danielsaul/emg-sensor-scenario/Images/Subsystem.png

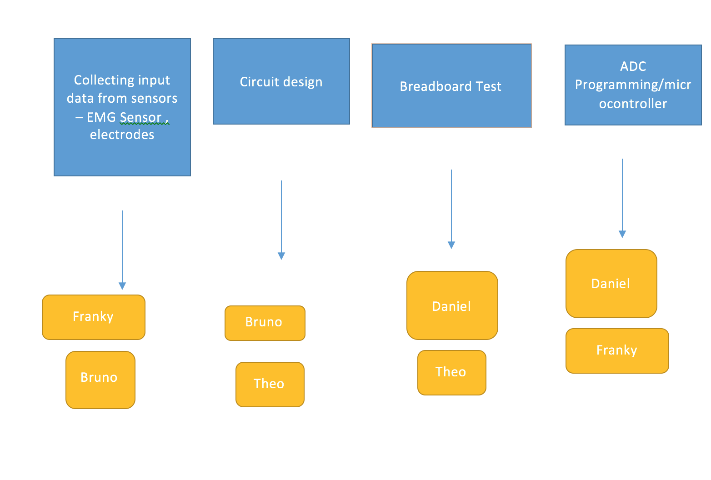
Images/Subsystem.png
