danielsaul/emg-sensor-scenario/Images/system multisim final with values.png

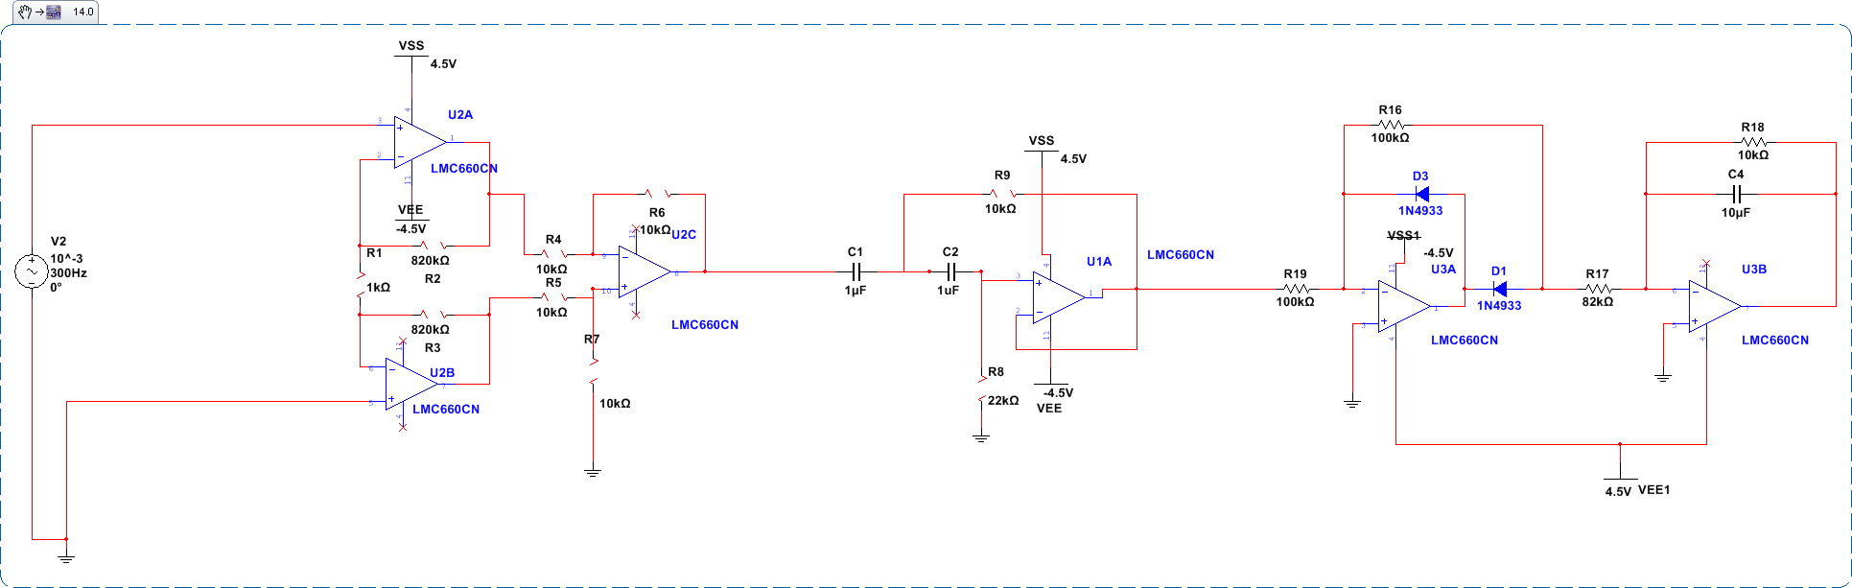
Images/system multisim final with values.png
