danielsaul/emg-sensor-scenario/Images/system-multisim-final-with-values.jpg

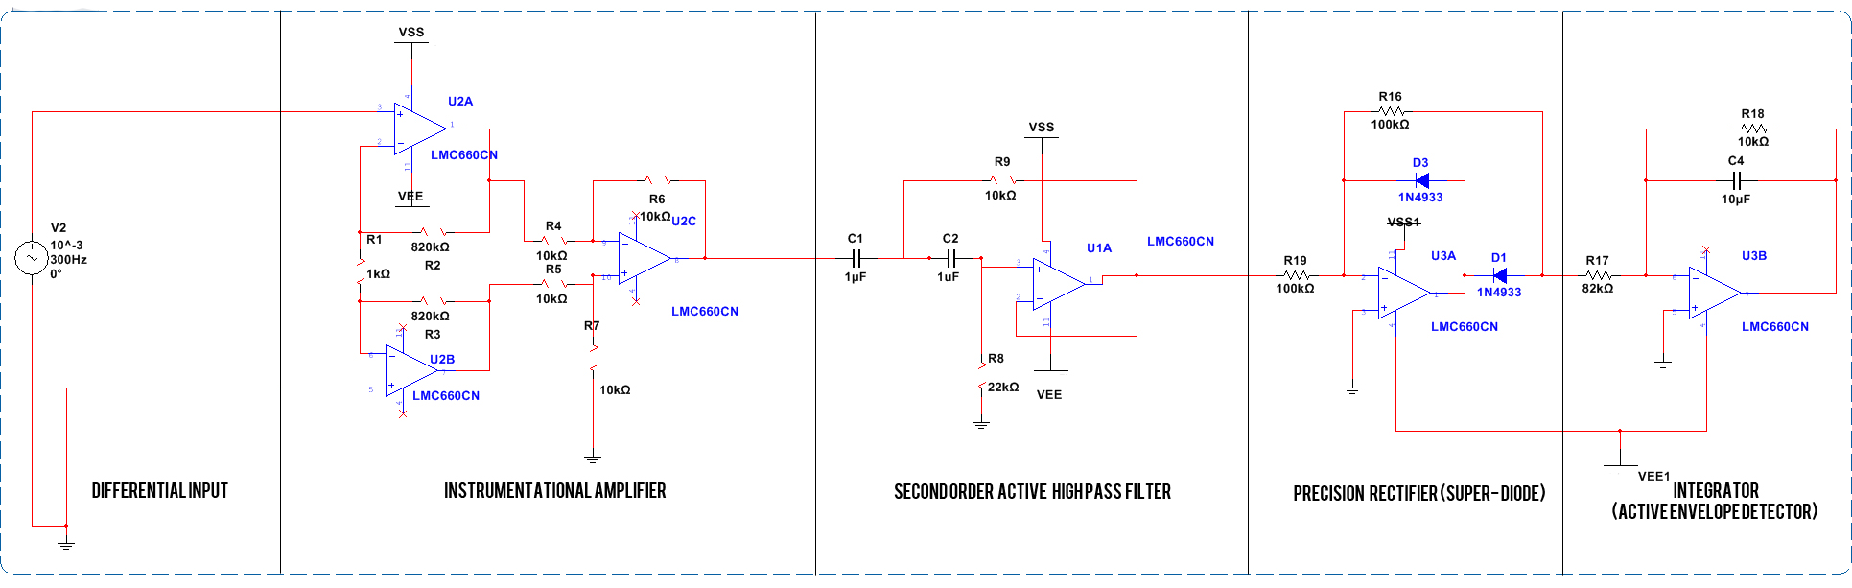
Images/system-multisim-final-with-values.jpg
