danielsaul/emg-sensor-scenario/(list of files, drawings)

Other design files:
Multisim Designs/FINALOVERALLCIRCUIT.ms14
Multisim Designs/MultisimCircuitDesign.ms14
Multisim Designs/rectifier and integrator.ms14
Multisim Designs/secondorderactivehighpassfilter.ms14
PCB/pcb.dip
PCB/schematic.dch
PCB/template.dip
