danielsaul/emg-sensor-scenario/(commit log)

2015-11-02 added multisim folder and files
    [MultisimCircuitDesign.ms13]
2015-11-03 updated multisim designs from my comp
    [MultisimCircuitDesign.ms14, design.dip, rectifier and integrator.ms14, template.dip]
2015-11-03 added up to date multisim files and Docx
    [MultisimCircuitDesign.ms13, MultisimCircuitDesign.ms14, rectifier-and-integrator.ms14, secondorderactivehighpassfilter.ms14]
2015-11-04 added final circuit multisim design
    [FINALOVERALLCIRCUIT.ms14]
2015-11-04 Schematic start, IA and HP
    [design.dip, schematic.dch]
2015-11-04 Rectifier & Integrator
    [schematic.dch]
2015-11-04 fixed rectifier and integrator circuit
2015-11-04 Arduino header, led, buttons
    [schematic.dch]
2015-11-04 Initial pcb components
    [pcb.dip]
2015-11-04 Finished PCB Layout
    [pcb.dip, schematic.dch]
2015-11-04 Added presentation
    For each slide, Bruno - do gain, Theo - do filtering, I'll do Rectifying, Dan - ADC/microcontroller, just write brief notes on that part, about technicalities involved. I'll then summarise and add pictures in the slide. This is so that at least everyone can talk about something if picked random.
2015-11-05 re-made the whole multismim design and got the correct values + wrote step by step procedure to get to result on docx
    [FINALOVERALLCIRCUIT.ms14, rectifier and integrator.ms14]
